barreiroleo/Mascarilla-SanRafael/README.md

## Máscara de protección facial
Diseñada y producida para ser donadas. Proyecto realizado por el grupo Makers3D San Rafael (Mendoza - Argentina).
Este repositorio solo sirve al proposito de hosting para los archivos para la descarga pública.
