barreiroleo/Mascarilla-SanRafael/plano_visor_largo.jpg

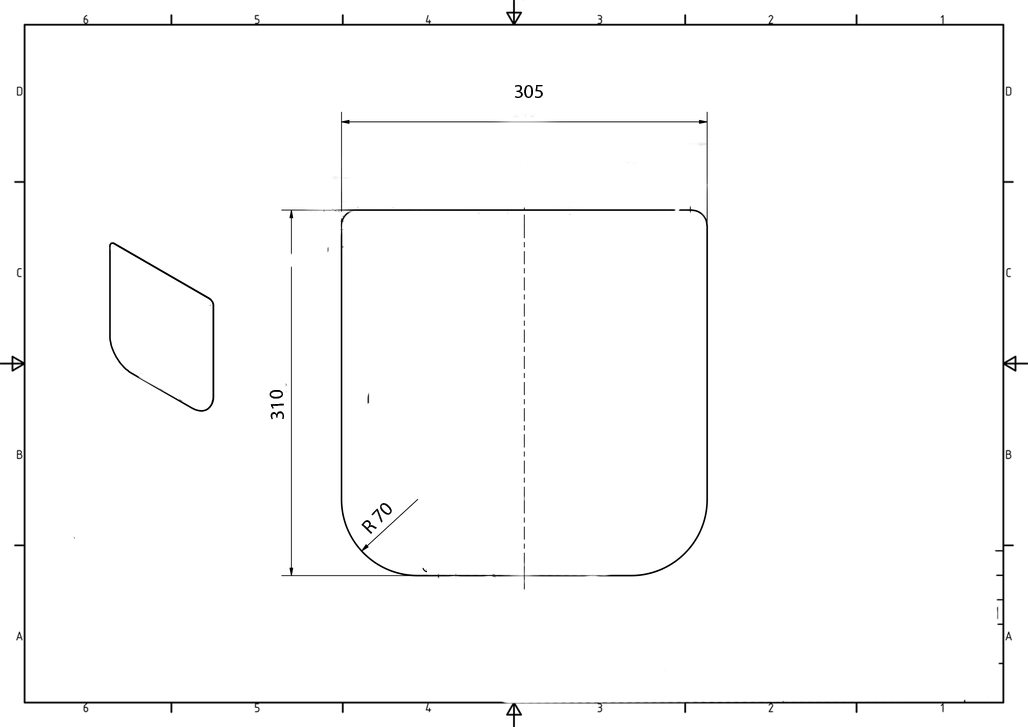
plano_visor_largo.jpg
