barreiroleo/Mascarilla-SanRafael/plano_visor_normal.jpg

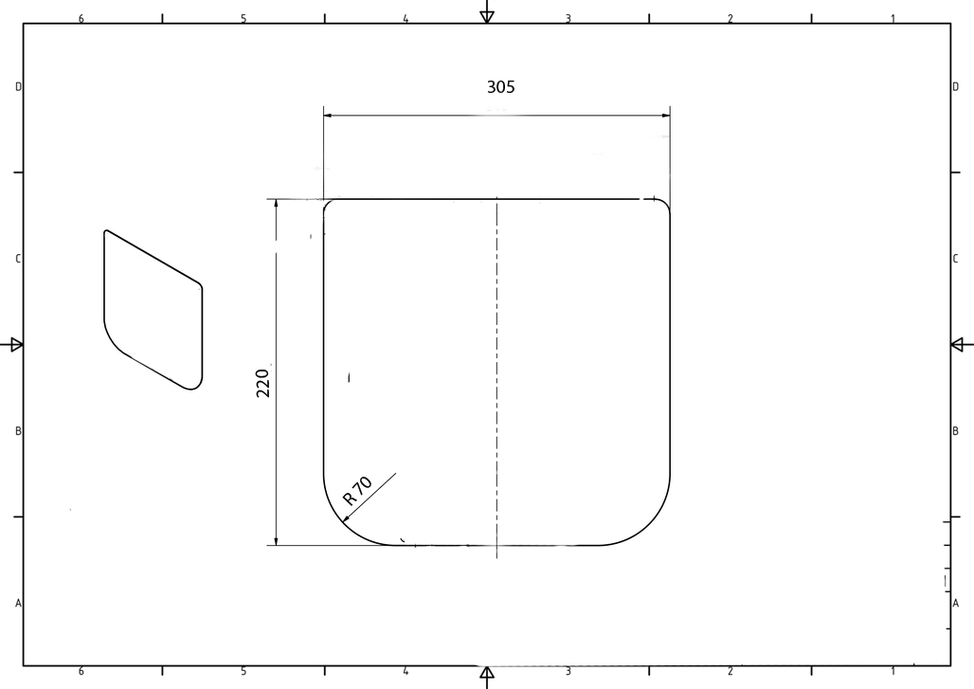
plano_visor_normal.jpg
