barreiroleo/Mascarilla-SanRafael/mascarilla ventilada 2.0 - doble impresion.stl

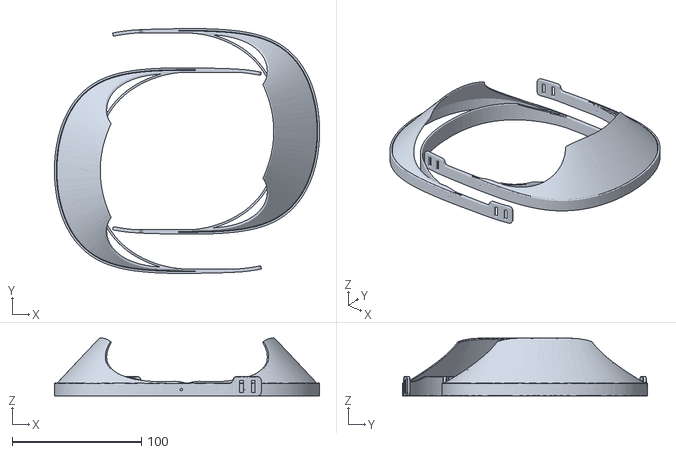
[picture p3: CAD file, 2020-03-22]
mascarilla ventilada 2.0 - doble impresion.stl
204.8 x 189.2 x 44.8
