barreiroleo/Mascarilla-SanRafael/visera_plana_cierre_ventilacion.stl

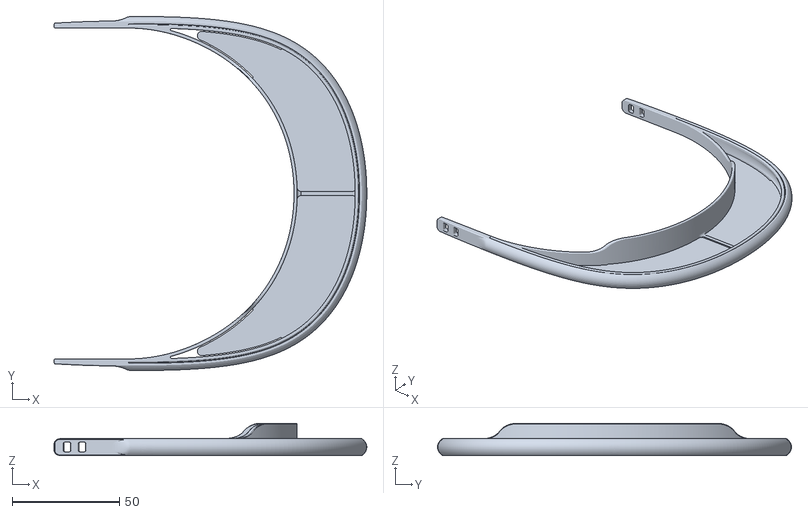
[picture p4: CAD file, 2020-03-22]
visera_plana_cierre_ventilacion.stl
145.6 x 164.8 x 15.0
