barreiroleo/Mascarilla-SanRafael/mascarilla ventilada 2.0.3mf

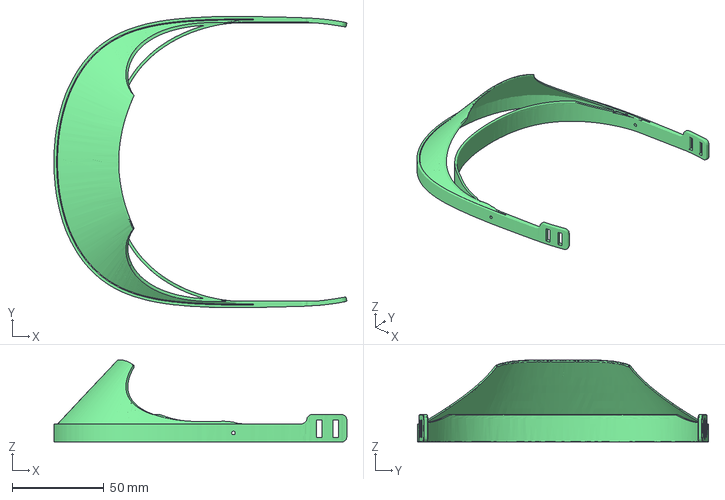
[picture p5: CAD file, 2020-03-22]
mascarilla ventilada 2.0.3mf
159.9 x 159.0 x 44.8 mm
