barreiroleo/Mascarilla-SanRafael/(list of files, cad)

Other CAD files:
mascarilla ventilada 2.0.stl
