barreiroleo/Mascarilla-SanRafael/plano_ambos_visores.pdf

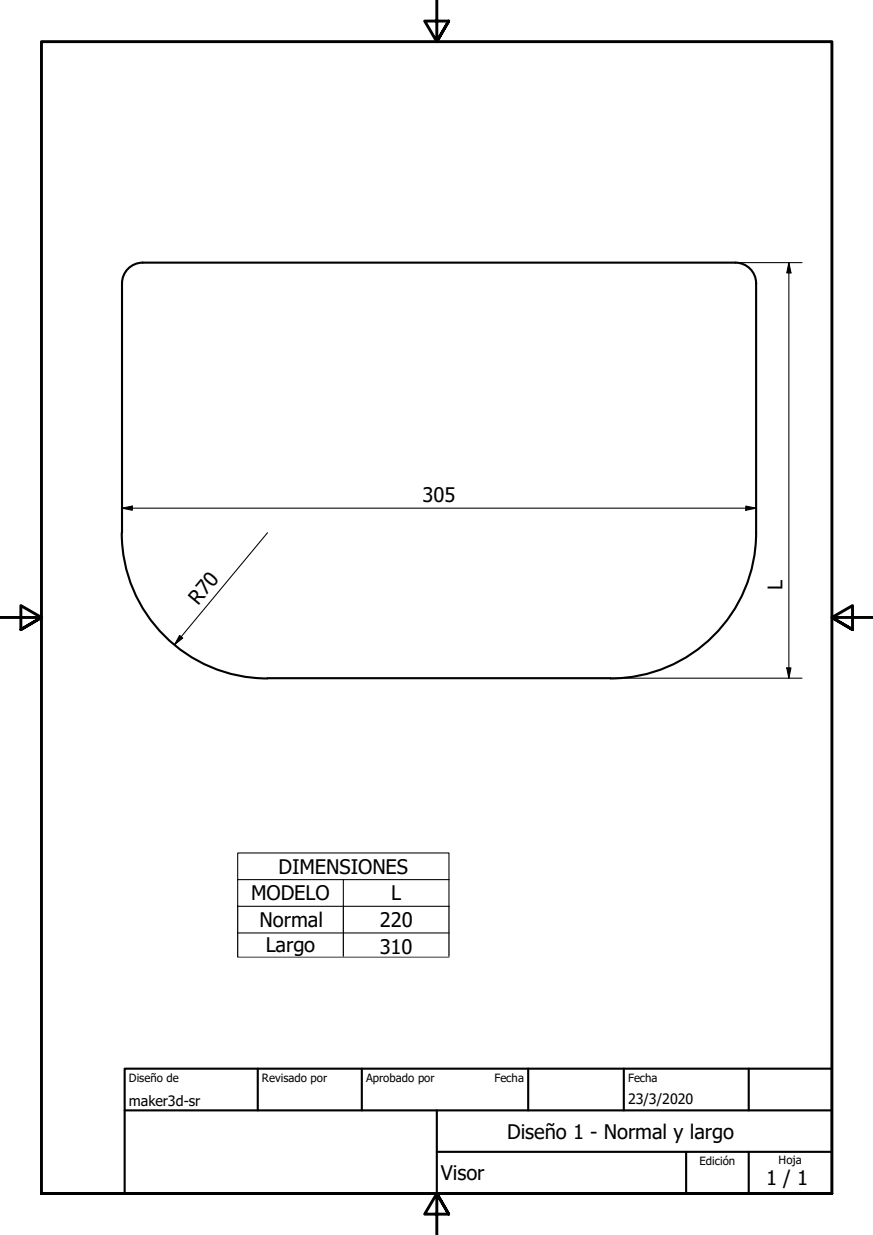
[picture p6: page 1]

MODELO | L
Normal | 220
Largo | 310

Disexo de maker3d-sr | Revisado por | Aprobado por Fecha | Fecha 23/3/2020

Disexo 1 - Normal y largo

Visor | Ediciyn | Hoja 1 / 1
