barreiroleo/Mascarilla-SanRafael/manual_visera_plana_cierre_ventilacion.pdf

# Manual de impresión y ensamblaje mascara protectora

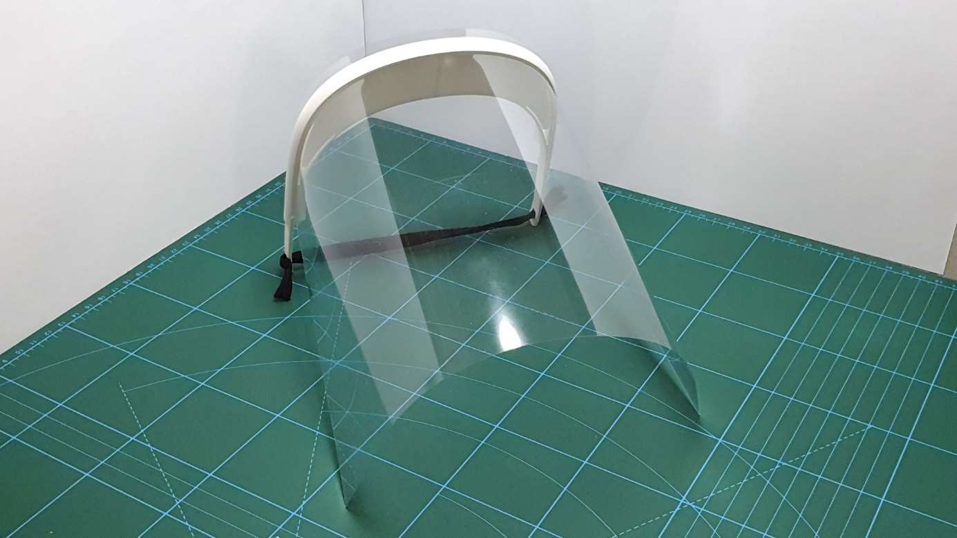
[picture p7: figure]

Página: 2/14

Página: 3/14

# Datos del Documento

Autor: | @YKA3D
Revisor: | @kermithenson
Fecha de publicación: | 18/03/2020
Observaciones:
Para comenzar a fabricar es necesario que la máquina esté correctamente calibrada. Una vez calibrada, se deberá llevar a cabo una prueba de tolerancia.

Test: https://www.thingiverse.com/thing:1662342

# Hoja de Cambios

Fecha | Versión | Autor | Cambios
18 de marzo de 2020 | v.0.1 | @YKA3D | Creación del documento
18 de marzo de 2020 | V.0.3 | @kermithenson | Modificación protocolos
20 de marzo de 2020 | V.0.9 | @YKA3D | Actualizaciones varias

# Versión STL

Fecha | Versión | Autor | Cambios
20 de marzo de 2020 | v.0.3 | @Hanochh | Creación STL mascara

Página: 4/14

# Índice

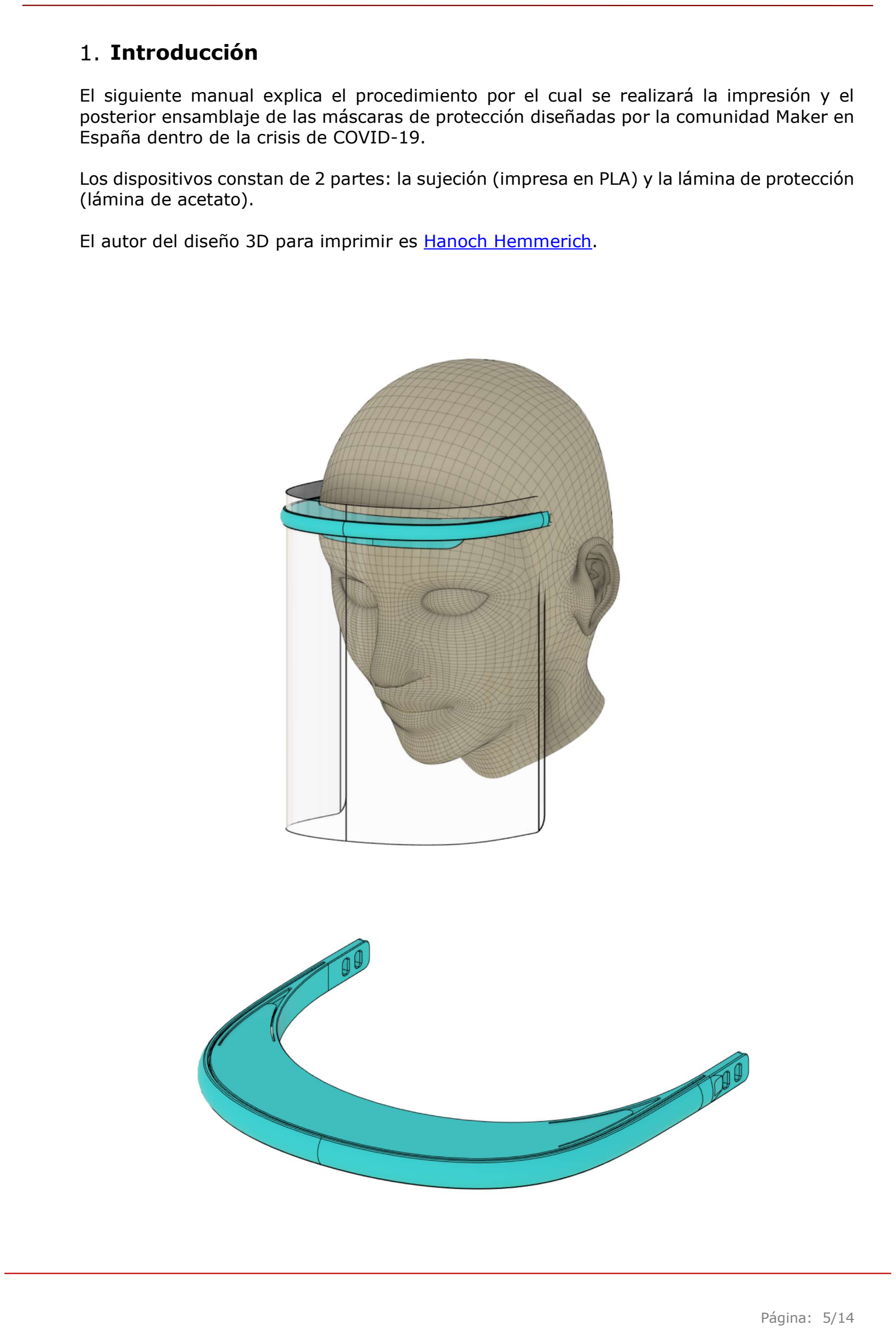
[picture p8: page 5]

Página: 5/14

### Introducción

El siguiente manual explica el procedimiento por el cual se realizará la impresión y el posterior ensamblaje de las máscaras de protección diseñadas por la comunidad Maker en España dentro de la crisis de COVID-19.

Los dispositivos constan de 2 partes: la sujeción (impresa en PLA) y la lámina de protección (lámina de acetato).

El autor del diseño 3D para imprimir es Hanoch Hemmerich.

Página: 6/14

### Enlace de compras

Los siguientes enlaces solo son una referencia del material utilizado para la elaboración de las pantallas protectoras.

- Láminas de encuadernar
o 180 micras
https://www.amazon.es/Fellowes-Cristal-Portadas-encuadernaci%C3%B3ntransparente/dp/B002BARBEK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
o 240 micras
https://www.amazon.es/gp/product/B000YC1UWG/ref=ppx_yo_dt_b_asin_title_o00_s00?ie=UTF8&psc=1
- Goma elástica
https://www.amazon.es/Banda-el%C3%A1stica-personalizada-Artesan%C3%ADametros/dp/B0749M5CBF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

### Parámetros de impresión

El archivo para su impresión se puede descargar desde el siguiente enlace:

Enlace de descarga

Los parámetros de impresión solo son una guía de referencia cada uno conoce bien su máquina y los límites de esta:

- Diámetro del Nozzle: 0.4mm
- Altura de capa: 0.28mm
- Relleno: 50%
- Tipo de relleno: Rejilla
- Capas superiores: 4
- Capas inferiores: 2
- Flujo: 80%
- Sin soportes
- Velocidad de impresión:
o Perímetros: 80mm/s
o Perímetros pequeños: 80mm/s o Perímetros externos: 80mms/s o Relleno: 80mms/s
o Relleno solido: 80mms/s
o Relleno solido superior: 80mm/s o Puentes: 80mm/s
o Relleno: 80mm/s
o Recorrido: 180mm/s

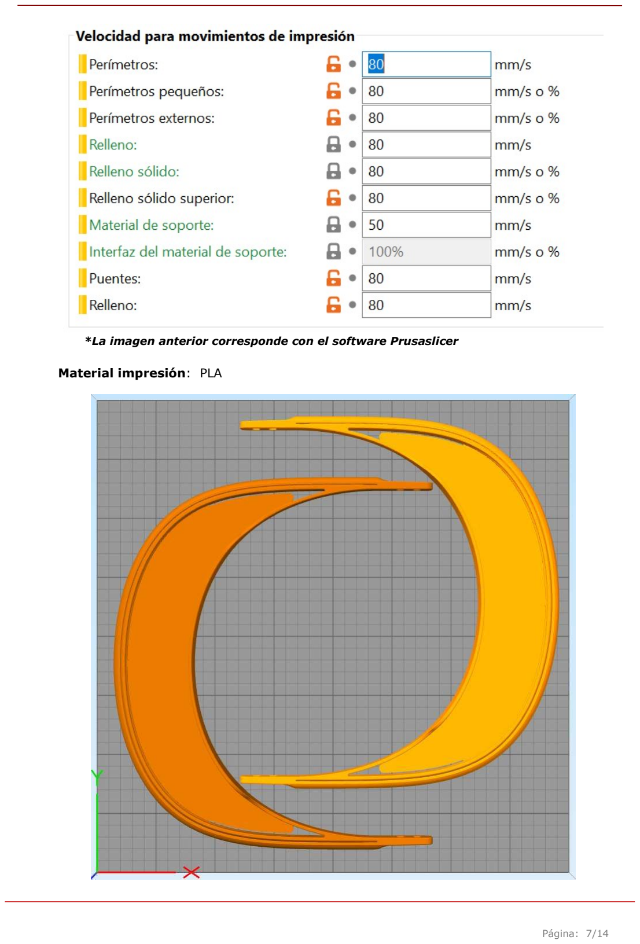
[picture p9: page 7]

Página: 7/14

*La imagen anterior corresponde con el software Prusaslicer

Material impresión: PLA

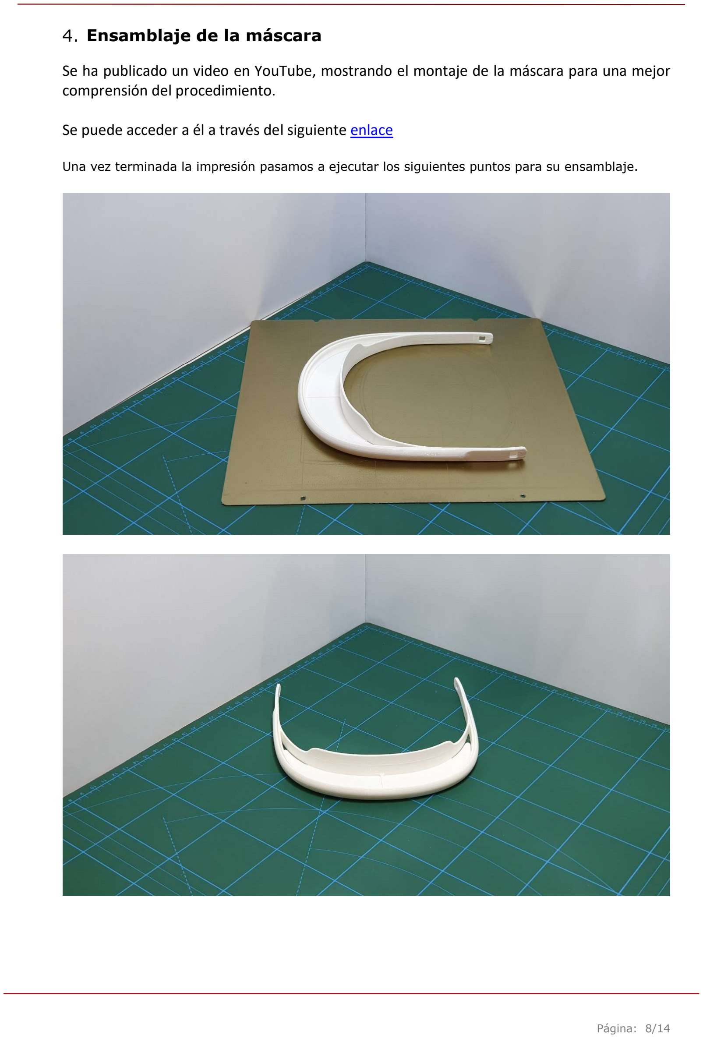
[picture p10: page 8]

Página: 8/14

### Ensamblaje de la máscara

### Se ha publicado un video en YouTube, mostrando el montaje de la máscara para una mejor

comprensión del procedimiento.

### Se puede acceder a él a través del siguiente enlace

Una vez terminada la impresión pasamos a ejecutar los siguientes puntos para su ensamblaje.

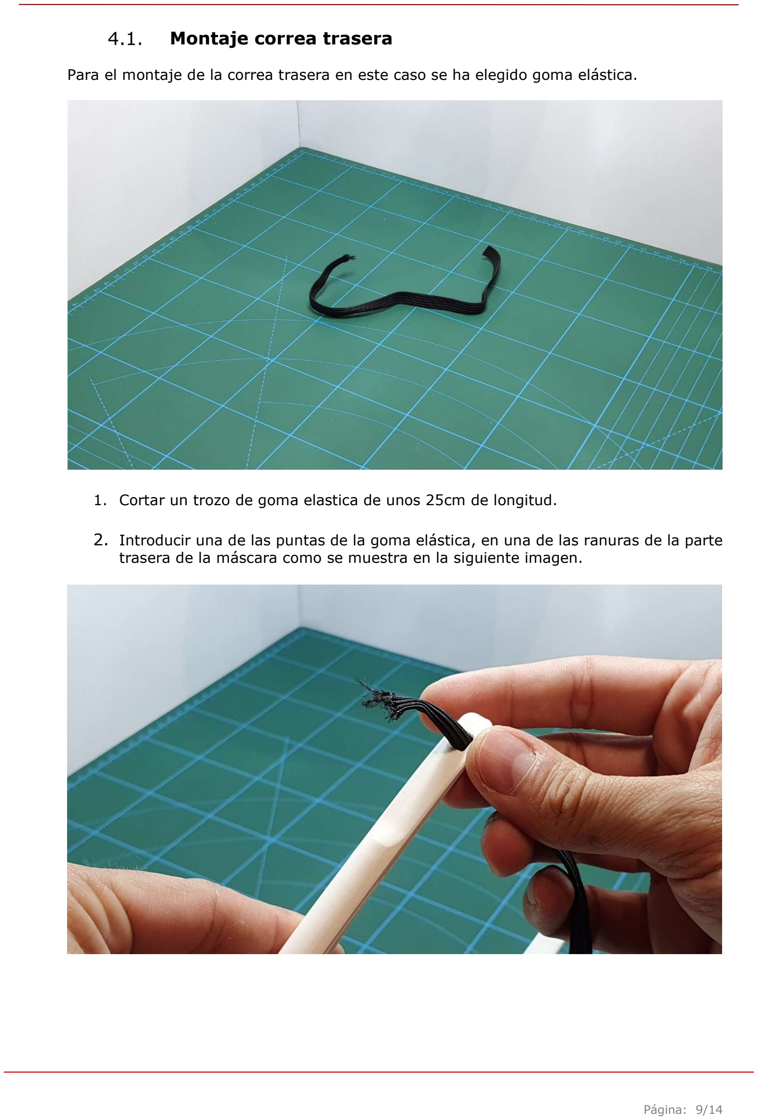
[picture p11: page 9]

Página: 9/14

### Montaje correa trasera

Para el montaje de la correa trasera en este caso se ha elegido goma elástica.

1. Cortar un trozo de goma elastica de unos 25cm de longitud.

### 2. Introducir una de las puntas de la goma elástica, en una de las ranuras de la parte

trasera de la máscara como se muestra en la siguiente imagen.

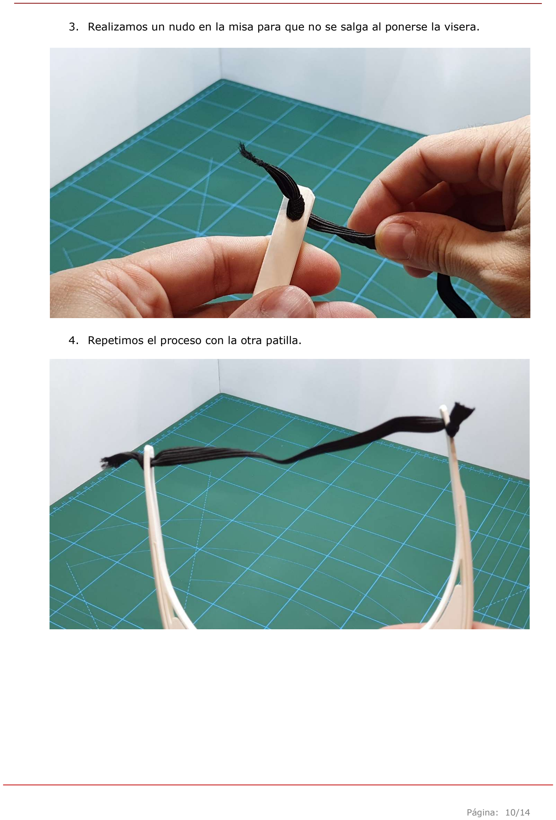
[picture p12: page 10]

Página: 10/14

3. Realizamos un nudo en la misa para que no se salga al ponerse la visera.
4. Repetimos el proceso con la otra patilla.

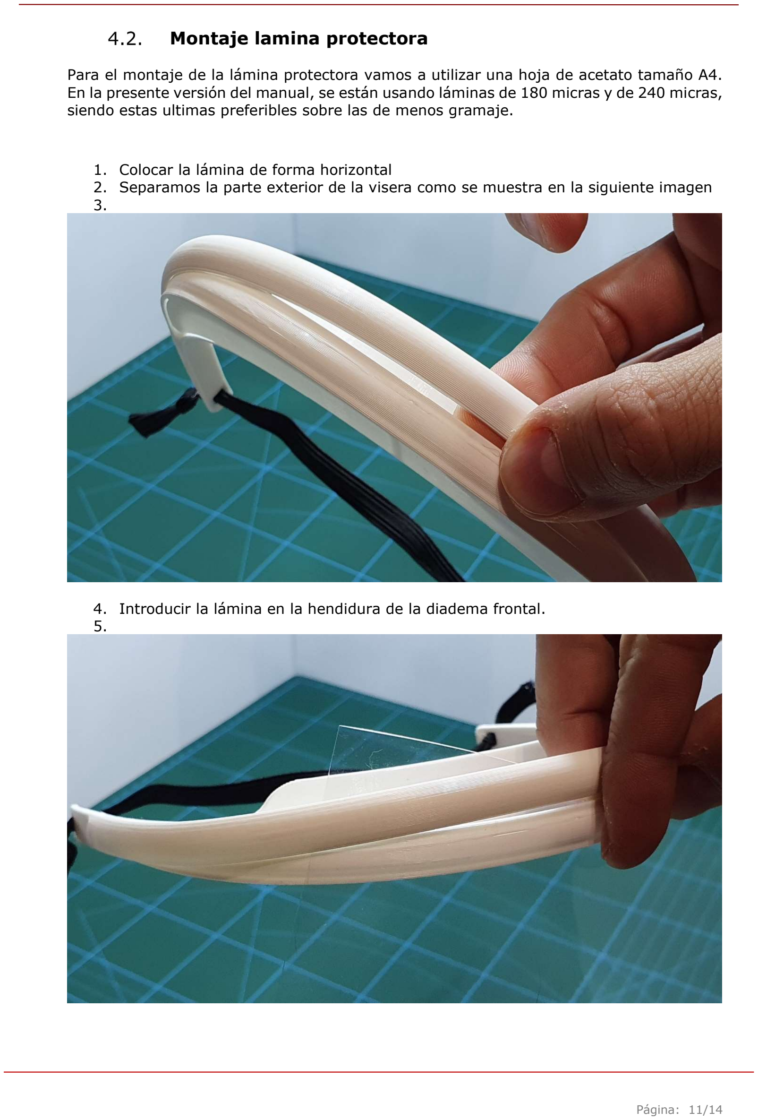
[picture p13: page 11]

Página: 11/14

### Montaje lamina protectora

Para el montaje de la lámina protectora vamos a utilizar una hoja de acetato tamaño A4. En la presente versión del manual, se están usando láminas de 180 micras y de 240 micras, siendo estas ultimas preferibles sobre las de menos gramaje.

### 1. Colocar la lámina de forma horizontal 2. Separamos la parte exterior de la visera como se muestra en la siguiente imagen

3.

4. Introducir la lámina en la hendidura de la diadema frontal. 5.

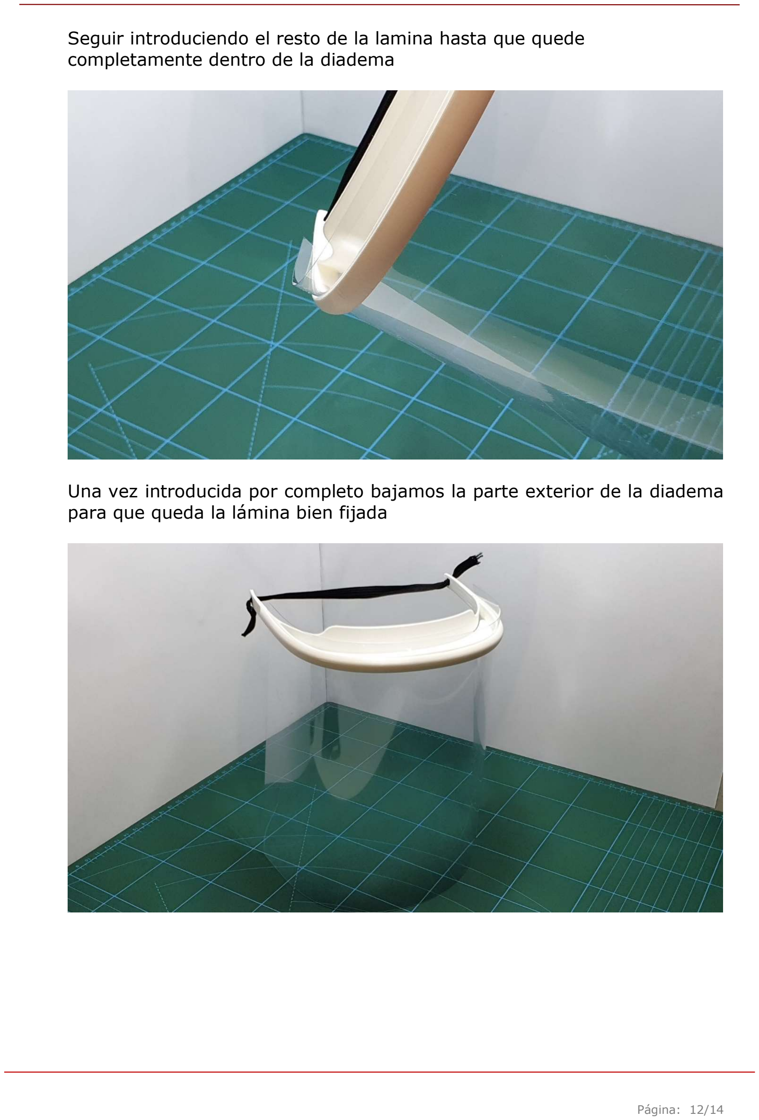
[picture p14: page 12]

Página: 12/14

### Seguir introduciendo el resto de la lamina hasta que quede completamente dentro de la diadema

### Una vez introducida por completo bajamos la parte exterior de la diadema para que queda la lámina bien fijada

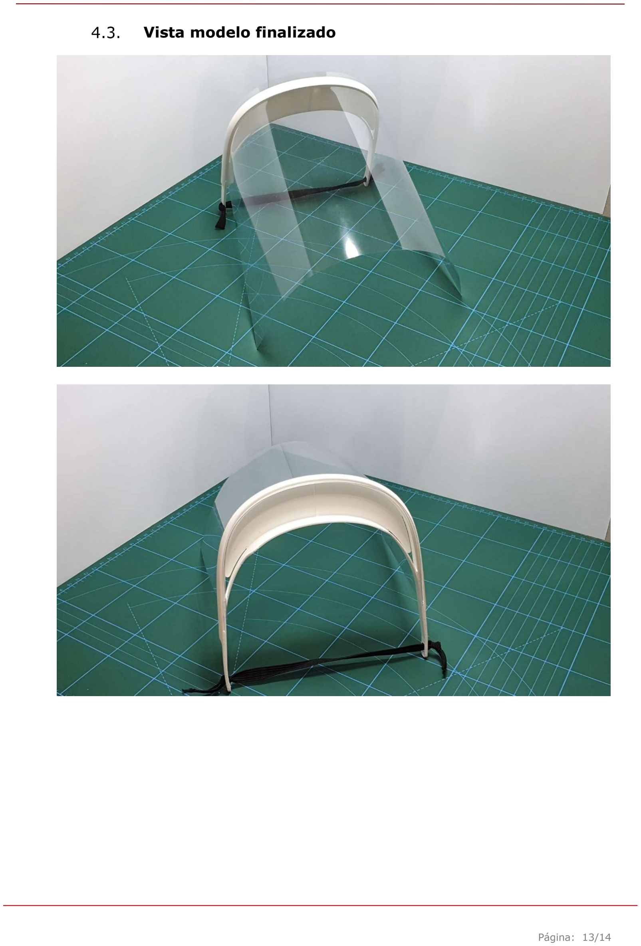
[picture p15: page 13]

Página: 13/14

### Vista modelo finalizado

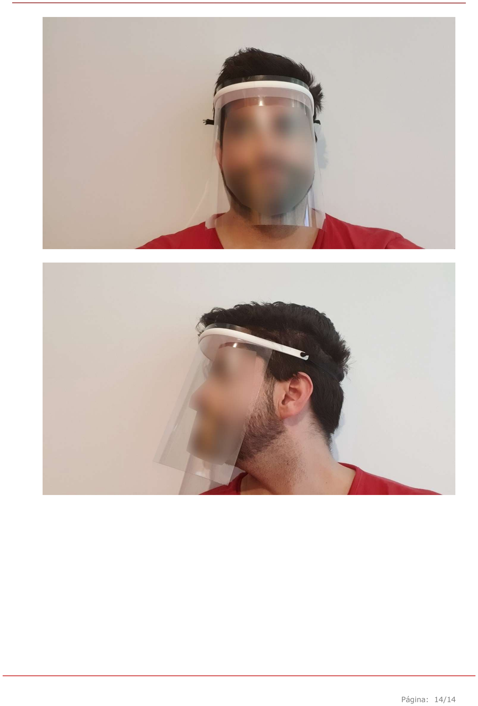
[picture p16: page 14]

Página: 14/14
